paulvee/Lars-GPSDO-V1/PCB-Top.jpg

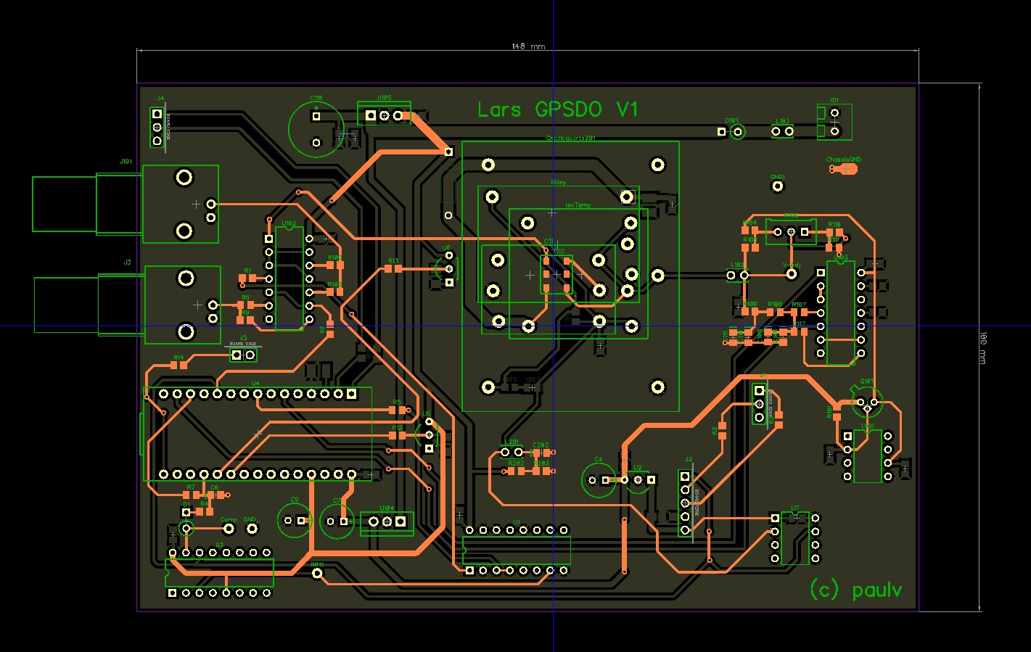
PCB-Top.jpg
