paulvee/Lars-GPSDO-V1/Controller Schematic V2.jpg

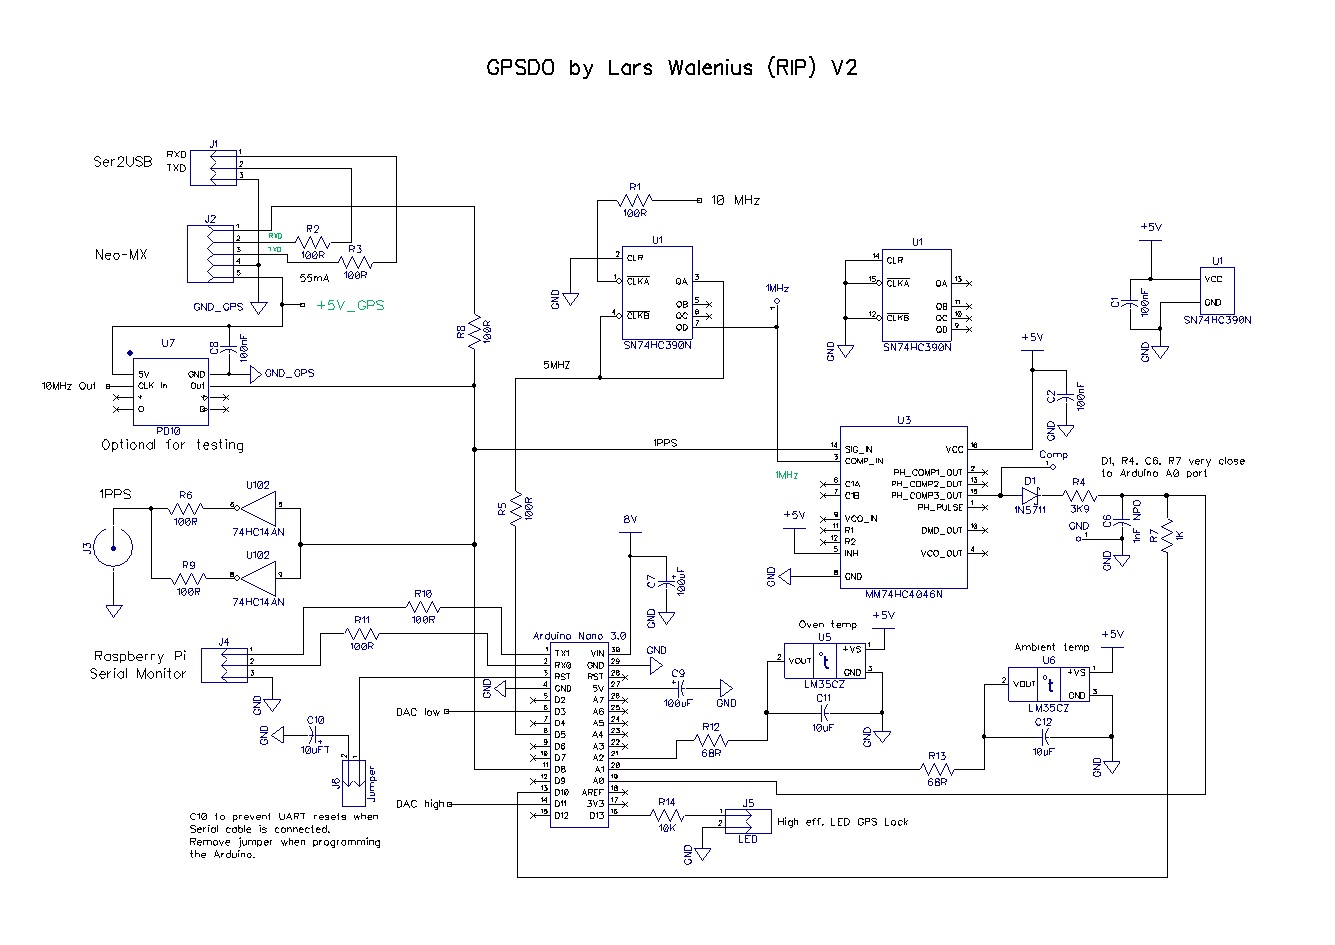
Controller Schematic V2.jpg
