paulvee/Lars-GPSDO-V1/Controller Schematic V2_1.jpg

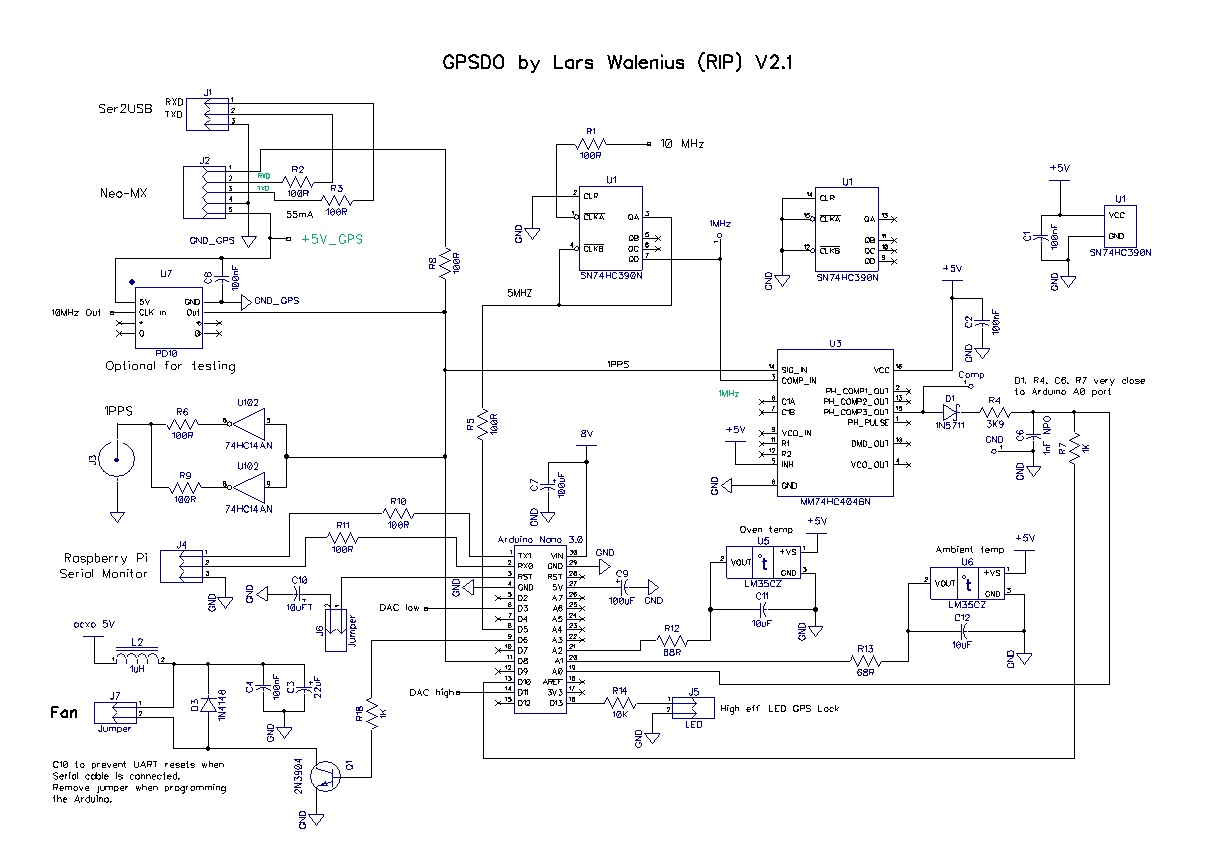
Controller Schematic V2_1.jpg
