paulvee/Lars-GPSDO-V1/Controller.jpg

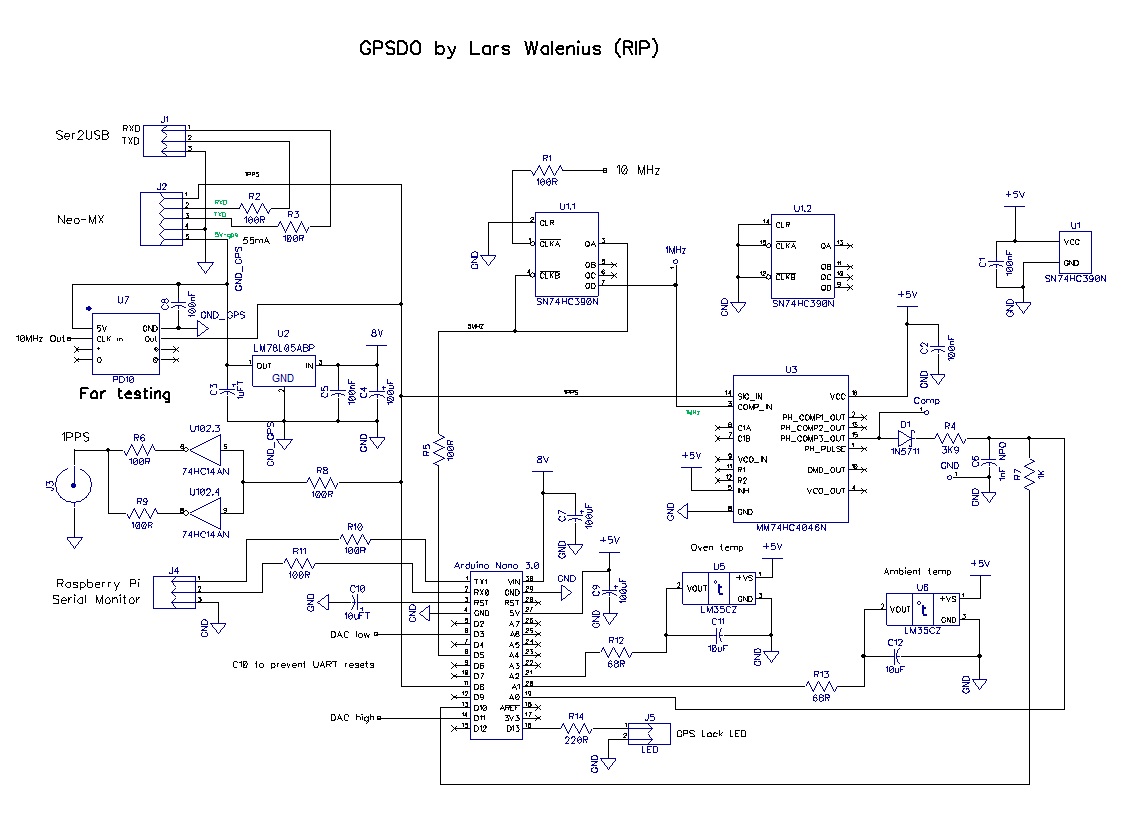
Controller.jpg
