paulvee/Lars-GPSDO-V1/CTI OCXO.jpg

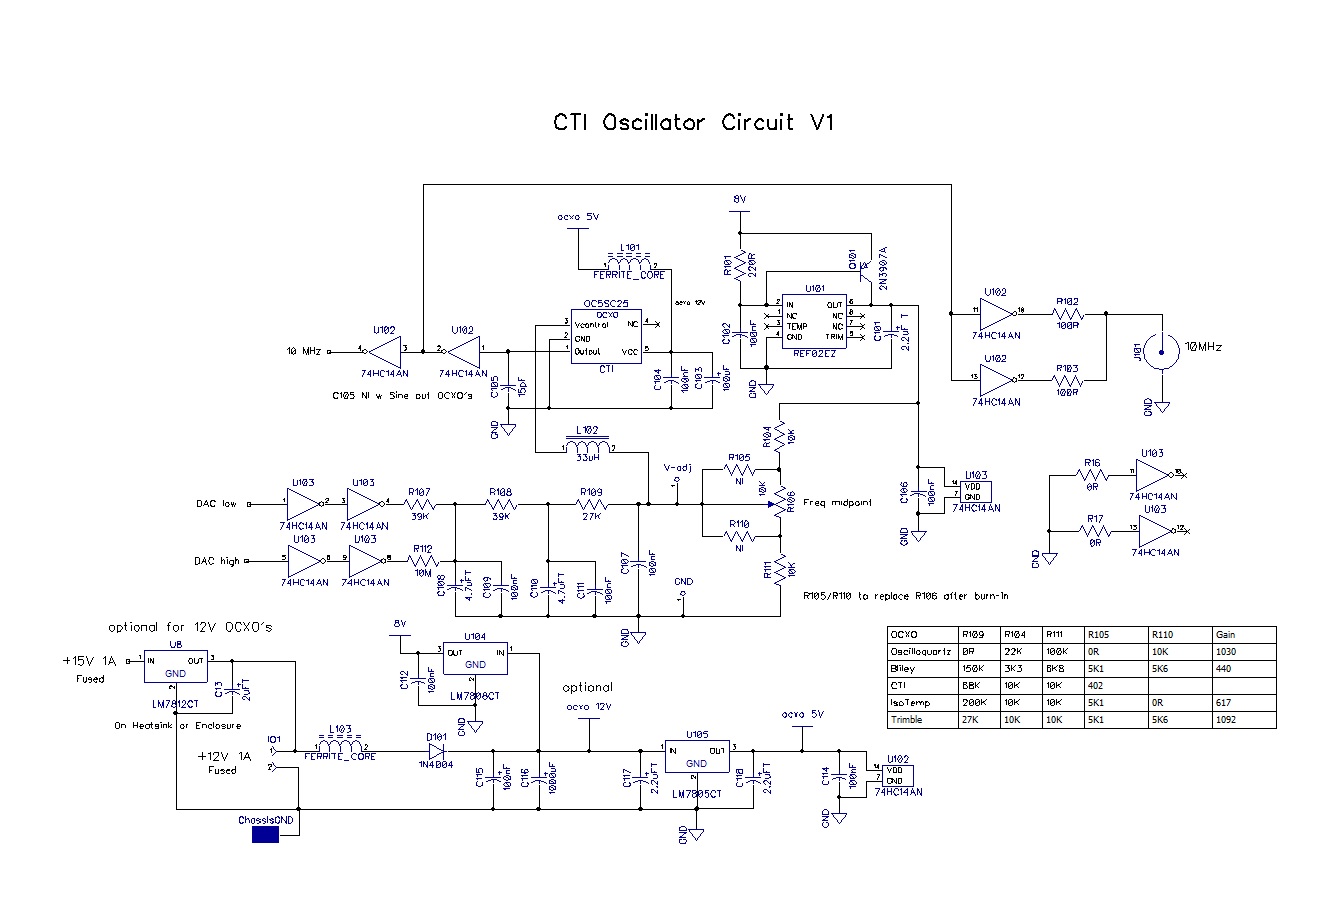
CTI OCXO.jpg
