paulvee/Lars-GPSDO-V1/Isolated Outputs.jpg

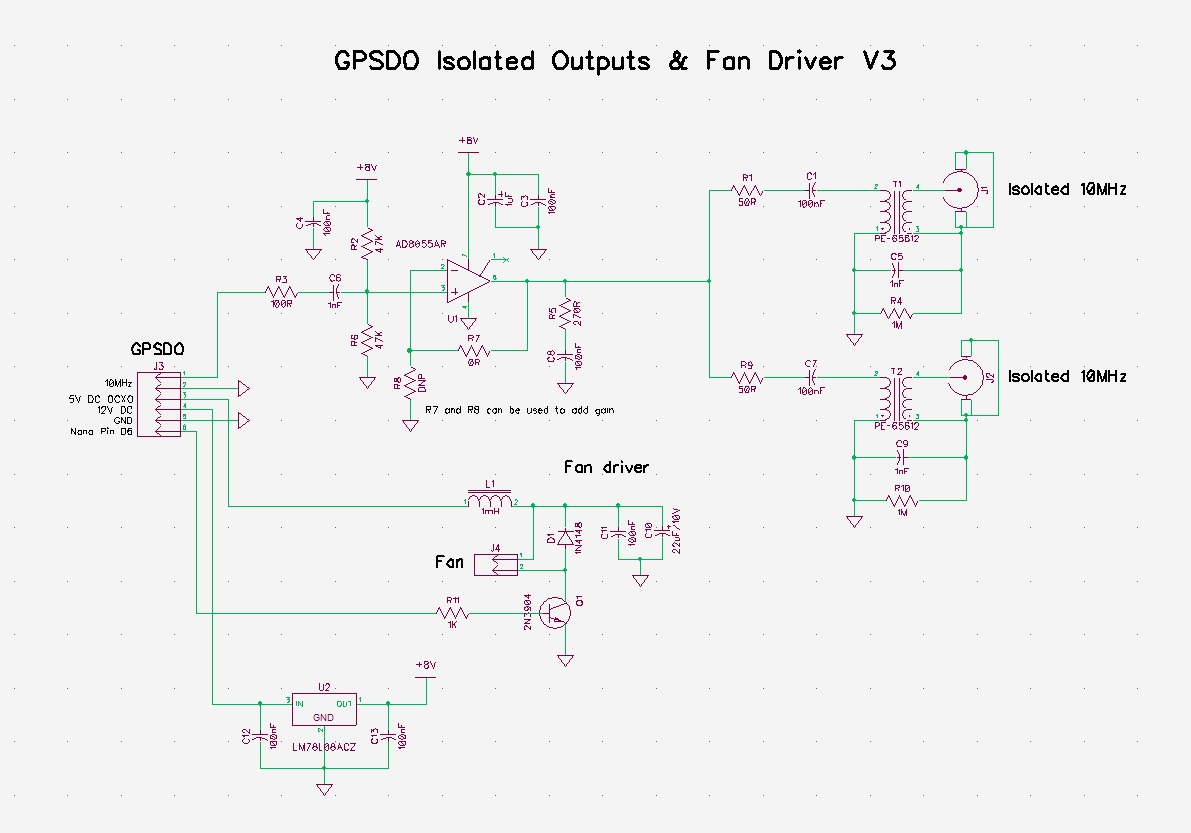
Isolated Outputs.jpg
