paulvee/Lars-GPSDO-V1/OCXO Schematic V2.jpg

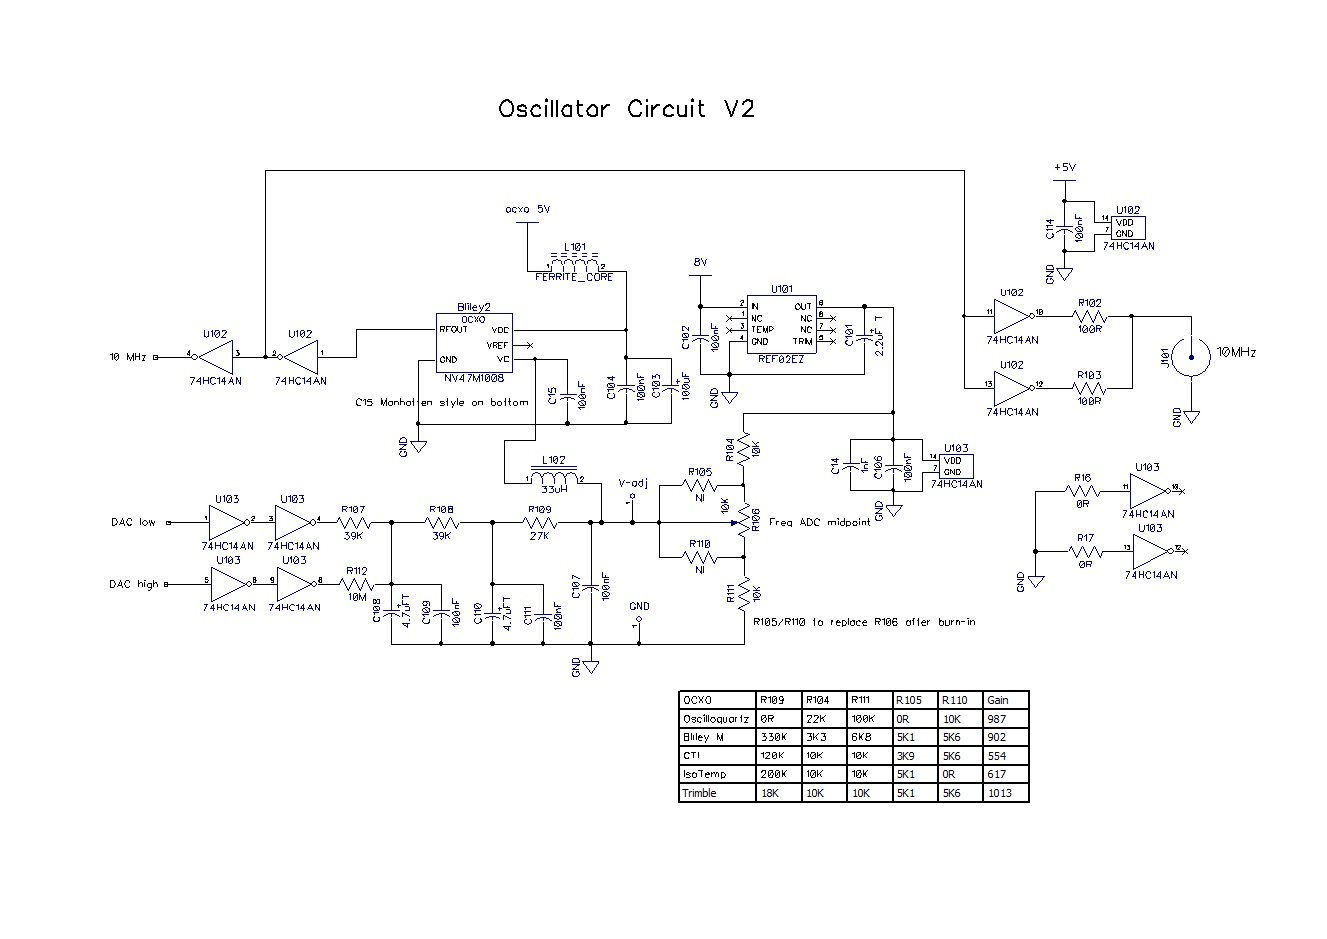
OCXO Schematic V2.jpg
