paulvee/Lars-GPSDO-V1/Other OCXOs V2.jpg

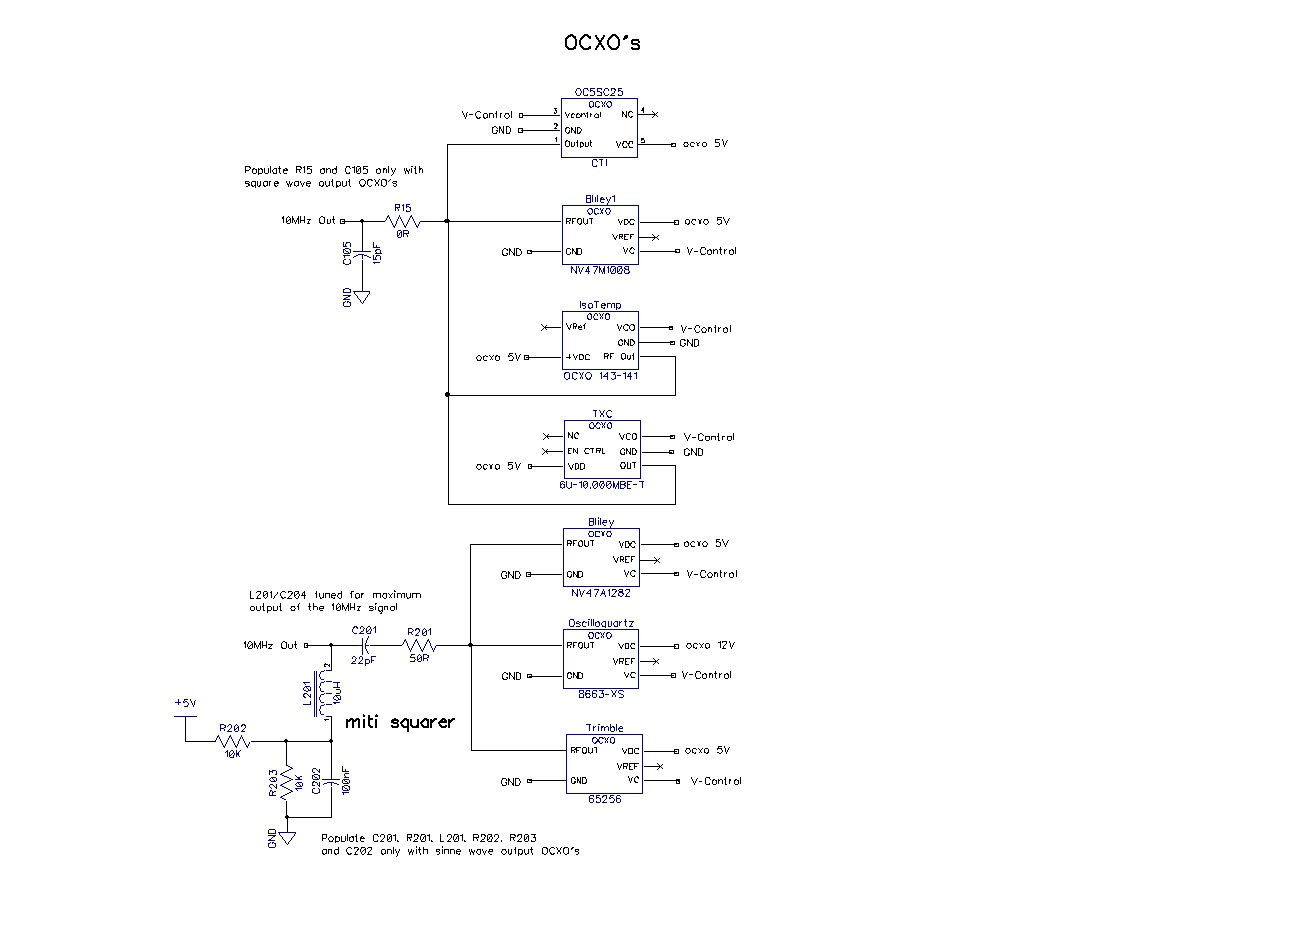
Other OCXOs V2.jpg
