paulvee/Lars-GPSDO-V1/Other OCXOs.jpg

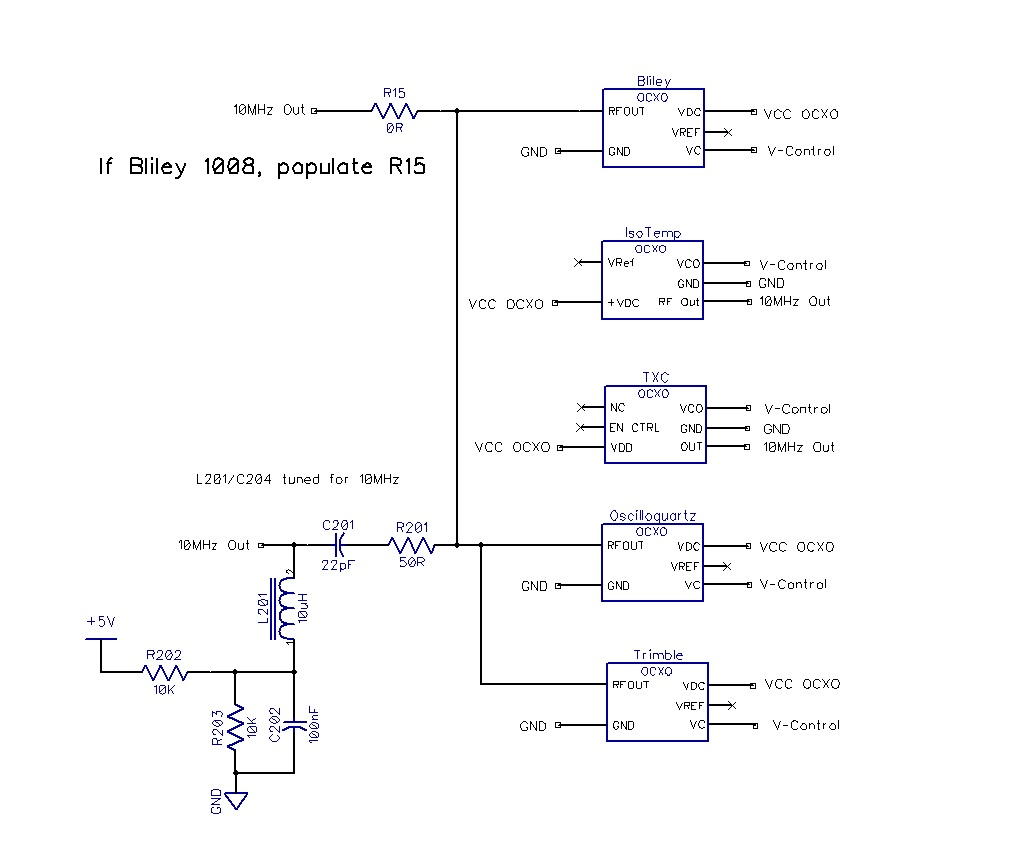
Other OCXOs.jpg
