paulvee/Lars-GPSDO-V1/PCB-Bottom.jpg

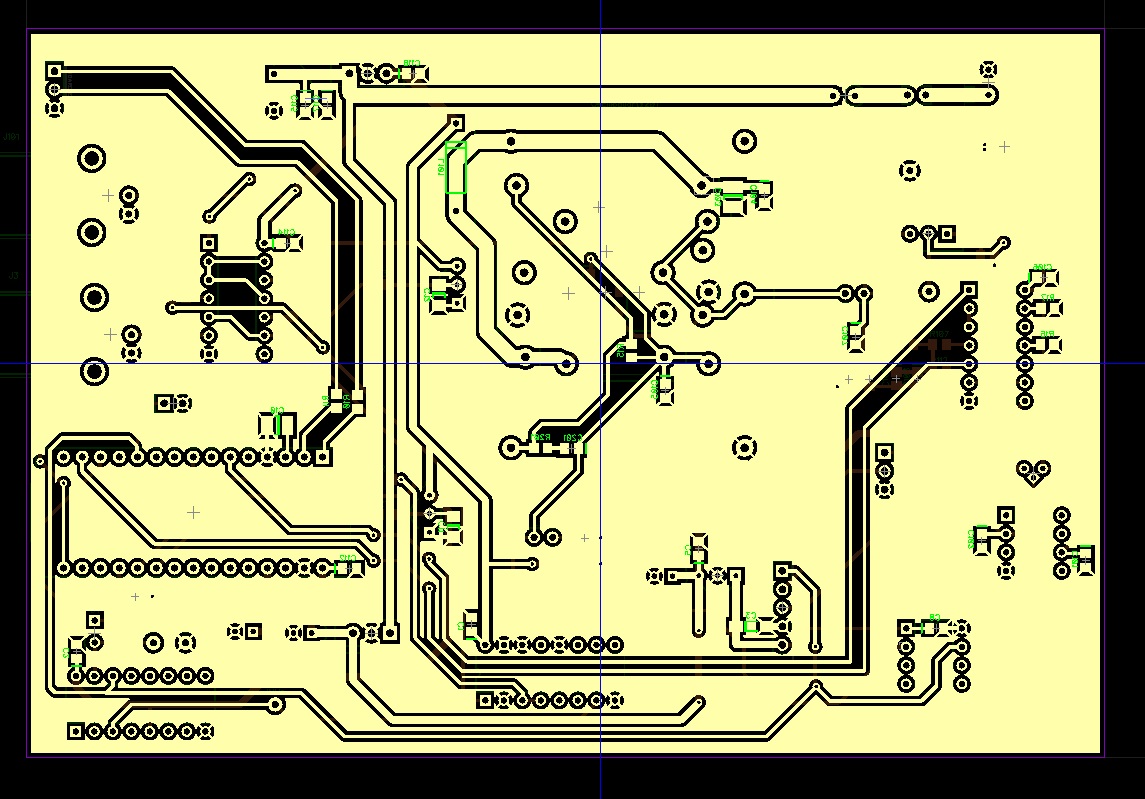
PCB-Bottom.jpg
