paulvee/Lars-GPSDO-V1/Power Distribution V2.jpg

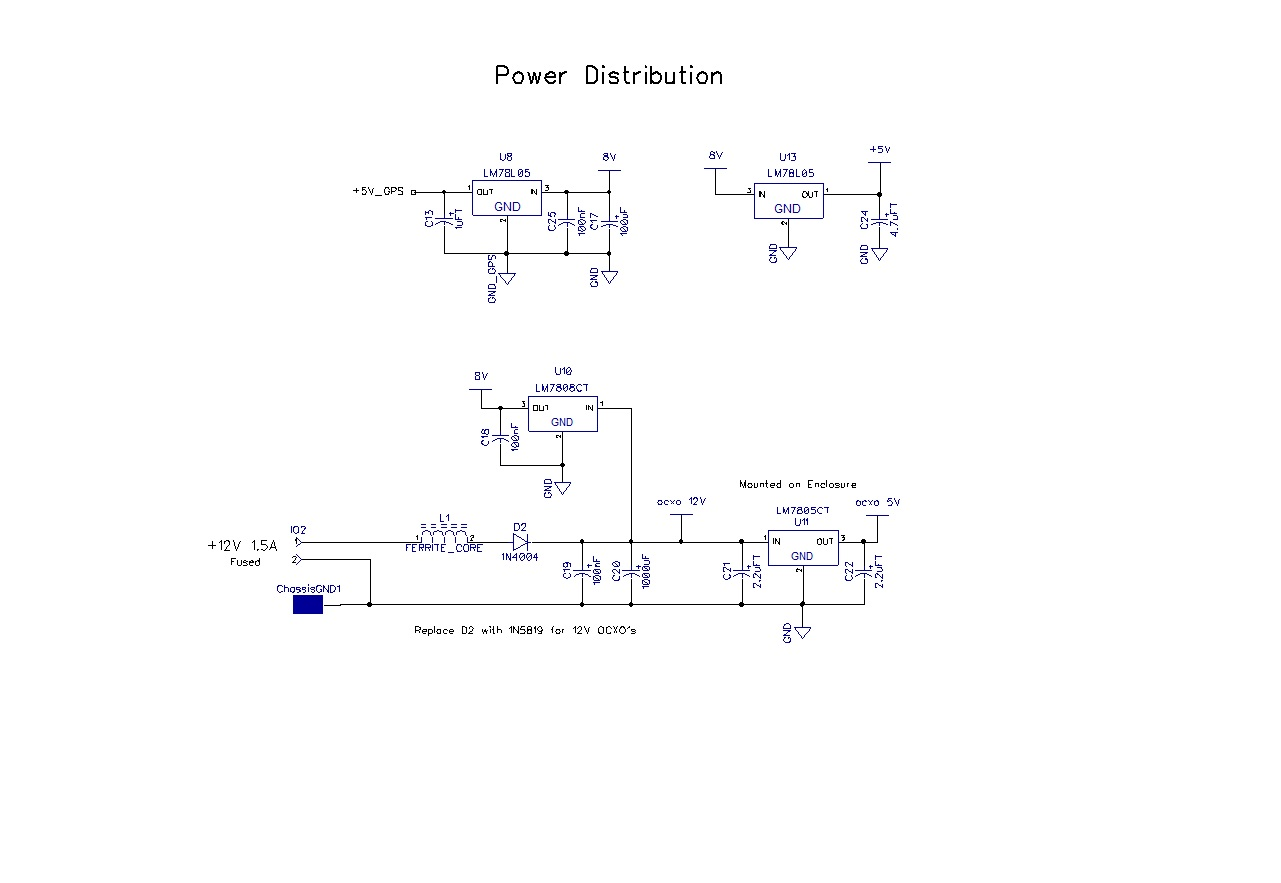
Power Distribution V2.jpg
