paulvee/Lars-GPSDO-V1/(commit log)

2020-06-02 Add files via upload
    Swapped the temp sensors
2020-09-08 Add files via upload
    Low pass filter added for the printing of the temperature sensors.
    Changed the temperature labels in the report to a more meaningful "OCXO" and "ambient"
2020-09-17 Add files via upload
    This has my optimum PID values tweaked for best results.
2020-09-24 Add files via upload
    Fixed an error in the PID controller, which used a removed constant.
2020-09-29 Add files via upload
    This version adds possibilities to enter the fan control parameters.
    maximum ambient temp, minimum PWM, Kp, Ki and Kd gain factors.
    Use f1 for help and f2 for values
2020-09-29 Add files via upload
    Adds support for on-the-fly changing of the fan controller parameters
2020-11-15 Add files via upload
    This is just an extraction from DipTrace, which is what I use. I initially did not plan for this design to become available. I did so because I was asked by several users, several of whom also bought my left-over PCB's.
    [BOM_V1.csv]
